petertorelli/marvin3/README.md

# Introduction

## Part 1: Motor Controller

See the readme in [readme in the mc folder](https://github.com/petertorelli/marvin3/blob/main/mc/README.md) the motor controller.
