petertorelli/marvin3/mc/images/voltage-across-bootstrap-diode.png

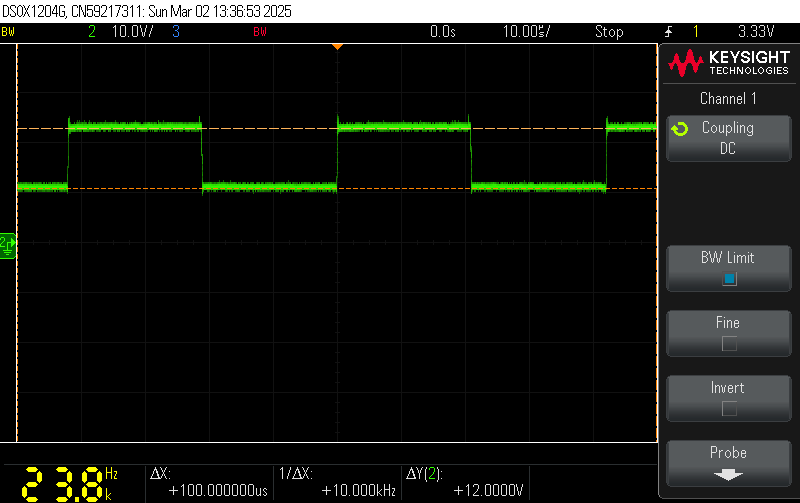
mc/images/voltage-across-bootstrap-diode.png
