petertorelli/marvin3/mc/kicad/ifx-mc-1.0.kicad_pcb

## KiCad design mc/kicad/ifx-mc-1.0.kicad_pcb (2025-03-07)

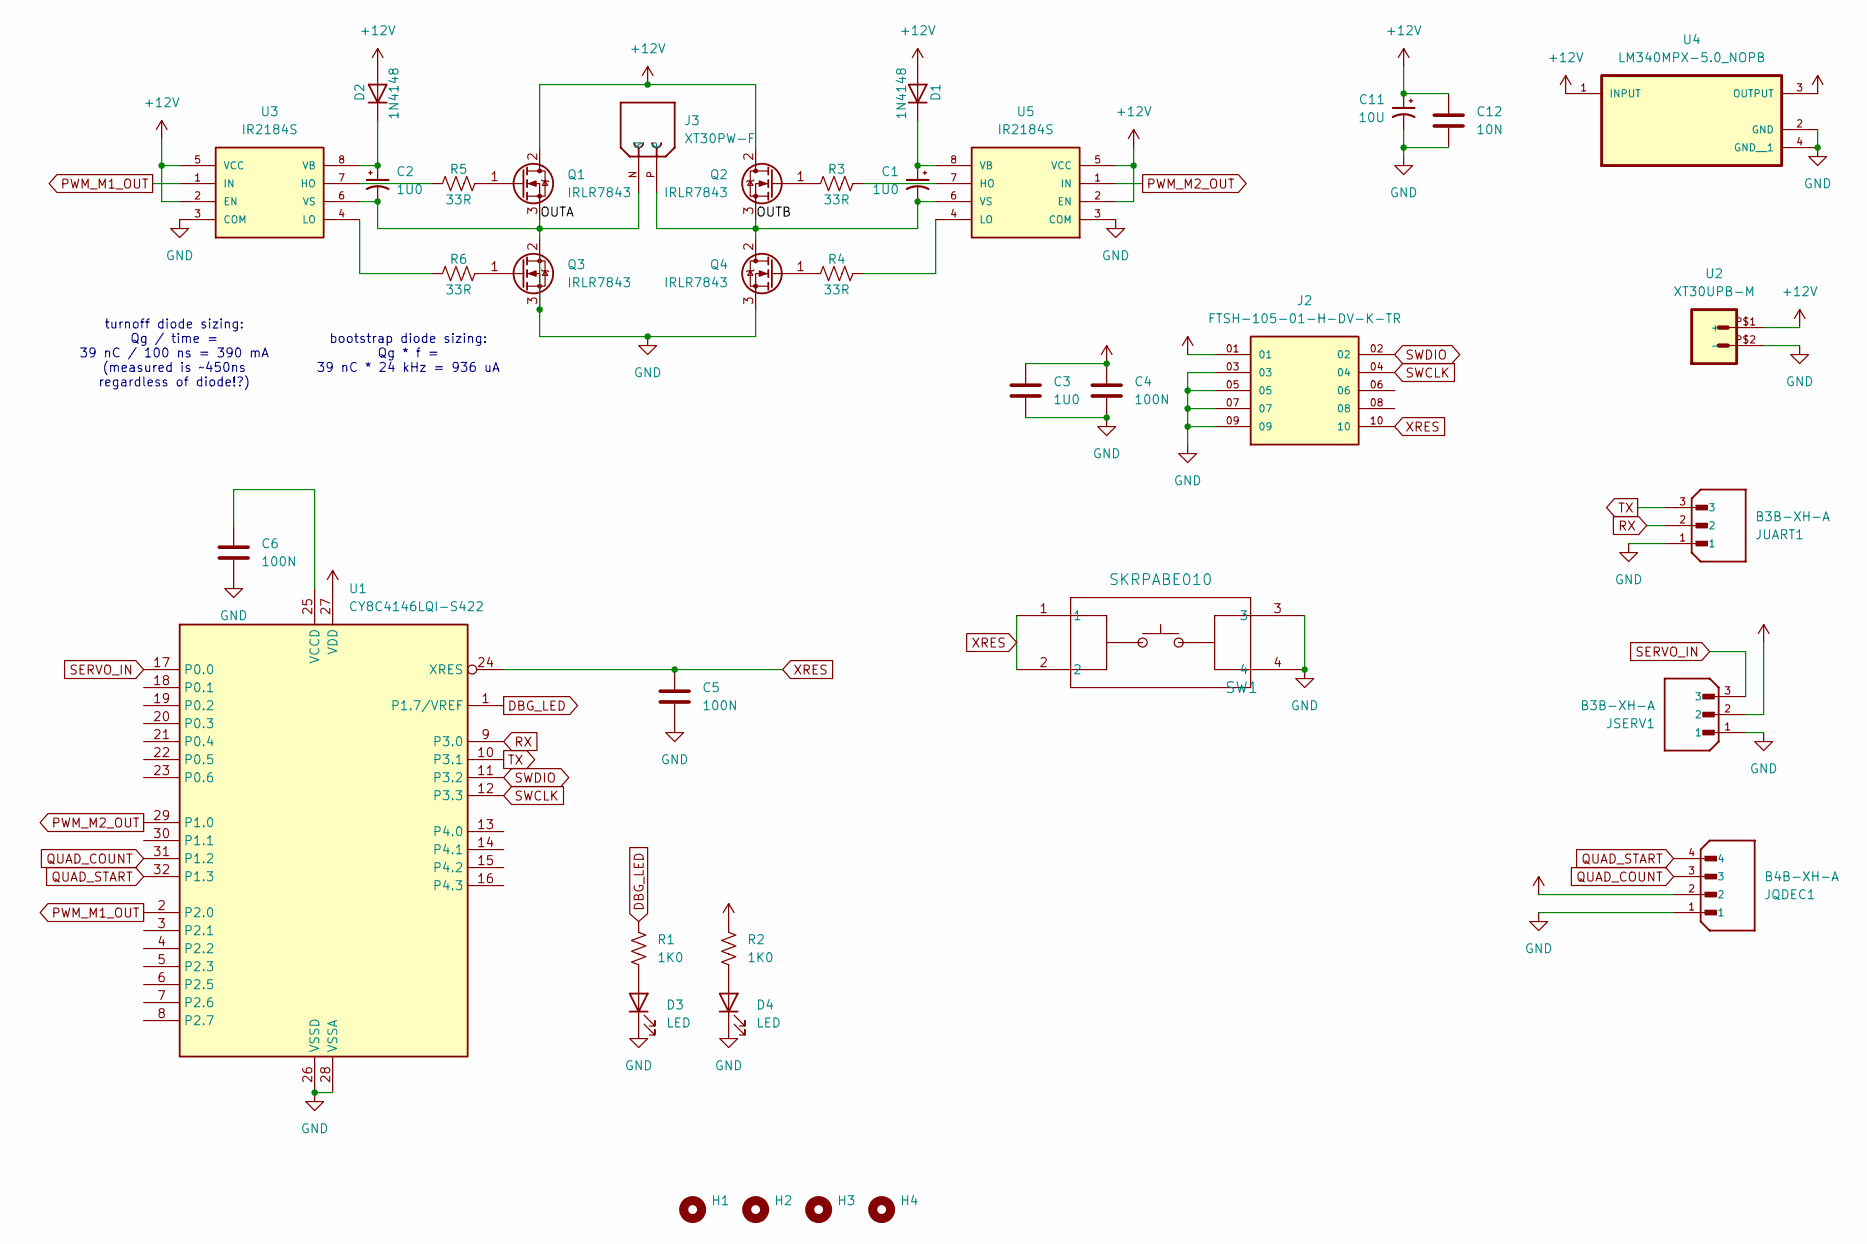
[picture p11: schematic ifx-mc-1.0.kicad_sch]

Parts:
C1, C2: 1U0; C_0603_1608Metric
C3: 1U0; C_0805_2012Metric
C4, C5, C6: 100N; C_0603_1608Metric
C11: 10U; CAP_865230340001
C12: 10N; C_0805_2012Metric
D1, D2: 1N4148; D_0603_1608Metric
D3, D4: LED; LED_0603_1608Metric_Pad1.05x0.95mm_HandSolder
H1, H2, H3, H4: MountingHole; MountingHole_3.2mm_M3_DIN965
J2: FTSH-105-01-H-DV-K-TR; SAMTEC_FTSH-105-01-H-DV-K-TR; PARTREV R
J3: XT30PW-F; AMASS_XT30PW-F; PARTREV 1.2
JQDEC1: B4B-XH-A; JST_B4B-XH-A; PARTREV 7/4/21
JSERV1: B3B-XH-A; JST_B3B-XH-A; PARTREV 7/4/21
JUART1: B3B-XH-A; JST_B3B-XH-A; PARTREV 7/4/21
Q1, Q2, Q3, Q4: IRLR7843; TO-252-2
R1, R2: 1K0; R_0603_1608Metric_Pad0.98x0.95mm_HandSolder
R3, R4, R5, R6: 33R; R_0603_1608Metric
SW1: SKRPABE010; SW4_SKRPABE010_ALPS
U1: CY8C4146LQI-S422; VQFN-32-1EP_5x5mm_P0.5mm_EP3.5x3.5mm
U2: XT30UPB-M
U3, U5: IR2184S; SOIC8_INF; MPN IR2184S
U4: LM340MPX-5.0_NOPB; SOT230P700X180-4N

Connections:
+12V: C11.1, C12.1, D1.2 (A), D2.2 (A), Q1.2 (D), Q2.2 (D), U2.P$1 (+), U3.2 (EN), U3.5 (VCC), U4.1 (INPUT), U5.2 (EN), U5.5 (VCC)
/OUTA: C2.2, J3.N, Q1.3 (S), Q3.2 (D), U3.6 (VS)
/OUTB: C1.2, J3.P, Q2.3 (S), Q4.2 (D), U5.6 (VS)
DBG_LED: R1.1, U1.1 (P1.7/VREF)
GND: C3.2, C4.2, C5.2, C6.2, C11.2, C12.2, D3.1 (K), D4.1 (K), J2.03, J2.05, J2.07, J2.09, JQDEC1.1, JSERV1.1, JUART1.1, Q3.3 (S), Q4.3 (S), SW1.3, SW1.4, U1.26 (VSSD), U1.28 (VSSA), U2.P$2 (-), U3.3 (COM), U4.2 (GND), U4.4 (GND__1), U5.3 (COM)
unnamed: C1.1, D1.1 (K), U5.8 (VB)
unnamed: C2.1, D2.1 (K), U3.8 (VB)
unnamed: D3.2 (A), R1.2
unnamed: D4.2 (A), R2.2
unnamed: Q1.1 (G), R5.1
unnamed: Q2.1 (G), R3.2
unnamed: Q3.1 (G), R6.1
unnamed: Q4.1 (G), R4.2
unnamed: C6.1, U1.25 (VCCD)
unnamed: R5.2, U3.7 (HO)
unnamed: R6.2, U3.4 (LO)
unnamed: R3.1, U5.7 (HO)
unnamed: R4.1, U5.4 (LO)
PWM_M1_OUT: U1.2 (P2.0), U3.1 (IN)
PWM_M2_OUT: U1.29 (P1.0), U5.1 (IN)
QUAD_COUNT: JQDEC1.3, U1.31 (P1.2)
QUAD_START: JQDEC1.4, U1.32 (P1.3)
RX: JUART1.2, U1.9 (P3.0)
SERVO_IN: JSERV1.3, U1.17 (P0.0)
SWCLK: J2.04, U1.12 (P3.3)
SWDIO: J2.02, U1.11 (P3.2)
TX: JUART1.3, U1.10 (P3.1)
VCC: C3.1, C4.1, J2.01, JQDEC1.2, JSERV1.2, R2.1, U1.27 (VDD), U4.3 (OUTPUT)
XRES: C5.1, J2.10, SW1.1, SW1.2, U1.24 (XRES)

Notes on the sheet:
bootstrap diode sizing: Qg * f = 39 nC * 24 kHz = 936 uA
turnoff diode sizing: Qg / time = 39 nC / 100 ns = 390 mA (measured is ~450ns regardless of diode!?)

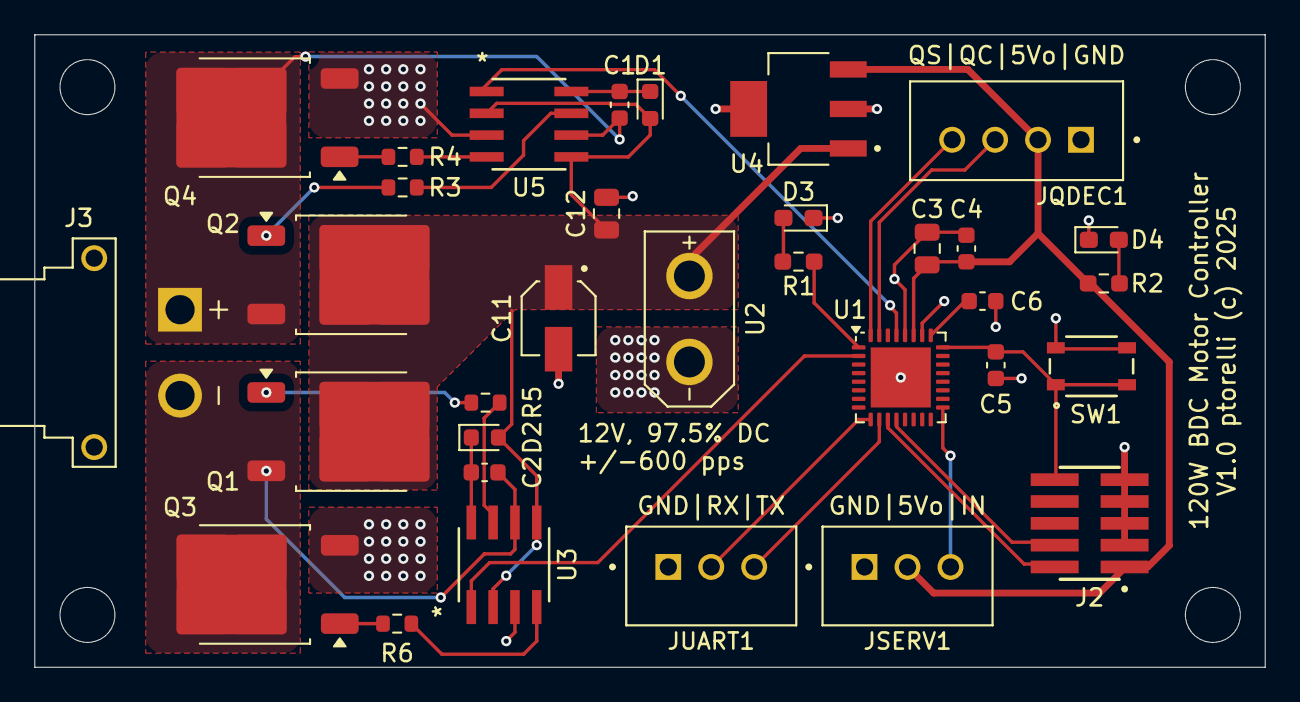
[picture p12: board ifx-mc-1.0.kicad_pcb from above]

Board: 2 copper layers, 71.6 x 36.8 mm, 37 parts (0 on the bottom side), 29 nets.
