petertorelli/marvin3/mc/kicad/ifx-mc-1.0-001.kicad_pcb

## KiCad design mc/kicad/ifx-mc-1.0-001.kicad_pcb (2025-03-07)

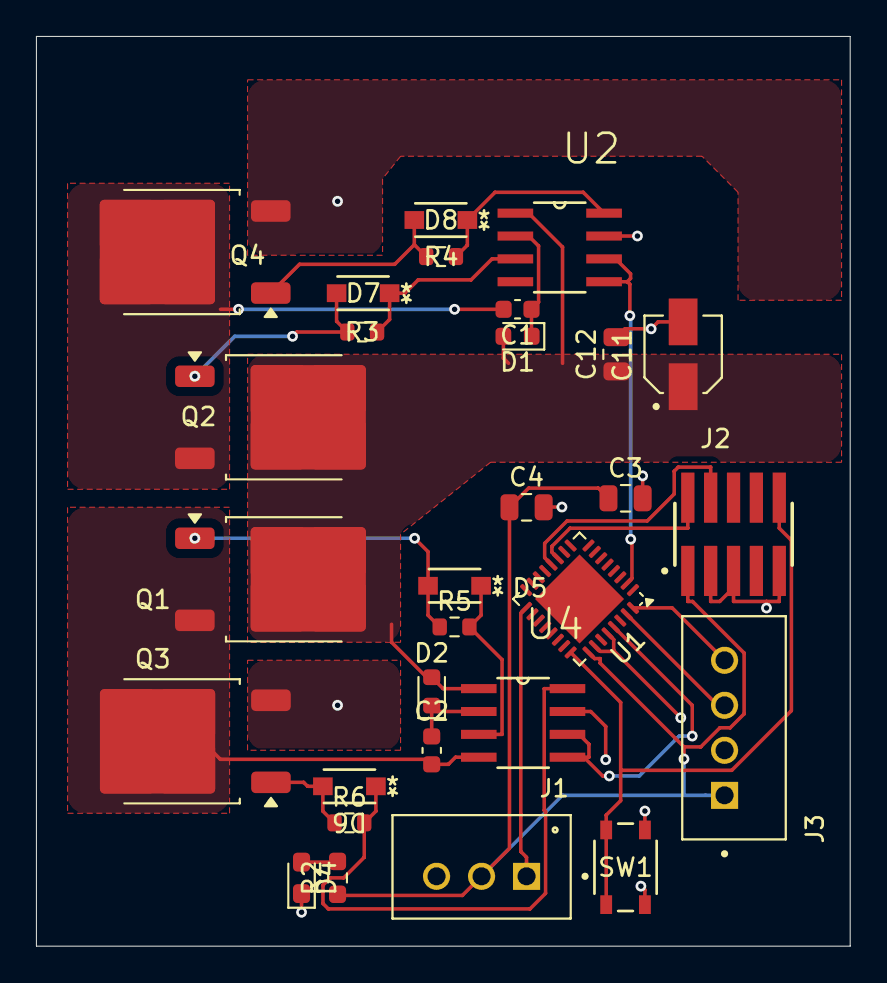
[picture p13: board ifx-mc-1.0-001.kicad_pcb from above]

Board: 2 copper layers, 45.2 x 50.5 mm, 29 parts (0 on the bottom side), 24 nets.

Parts:
C1, C2: 1U0; C_0603_1608Metric
C3, C4: C; C_0805_2012Metric
C11: 10U; CAP_865230340001
C12: 10N; C_0805_2012Metric
D1, D2: 1N4148; D_0603_1608Metric
D4: LED; LED_0603_1608Metric_Pad1.05x0.95mm_HandSolder
D5, D6, D7, D8: RF071MM2S; DIO_RB051MM_ROM
J1: B3B-XH-A; JST_B3B-XH-A
J2: FTSH-105-01-H-DV-K-TR; SAMTEC_FTSH-105-01-H-DV-K-TR
J3: B4B-XH-A; JST_B4B-XH-A
Q1, Q2, Q3, Q4: IRLR7843; TO-252-2
R2: R_US; R_0603_1608Metric_Pad0.98x0.95mm_HandSolder
R3, R4, R5, R6: 33; R_0603_1608Metric
SW1: SKRPABE010; SW4_SKRPABE010_ALPS
U1: CY8C4146LQI-S422; VQFN-32-1EP_5x5mm_P0.5mm_EP3.5x3.5mm
U2, U4: IR2011; SOIC127P600X175-8N

Connections:
+12V: C11.1, C12.1, D1.2 (A), D2.2 (A), Q1.2 (D), Q2.2 (D), U2.1 (VCC), U4.1 (VCC)
/OUTA: C2.2, Q1.3 (S), Q3.2 (D), U4.4 (VS)
/OUTB: C1.2, Q2.3 (S), Q4.2 (D), U2.4 (VS)
GND: C3.2, C4.2, C11.2, C12.2, D4.1 (K), J1.3, J2.03, J2.05, J2.09, J3.2, Q3.3 (S), Q4.3 (S), SW1.3, SW1.4, U1.26 (VSSD), U1.28 (VSSA), U2.7 (COM), U4.7 (COM)
unnamed: C1.1, D1.1 (K), U2.2 (VB)
unnamed: C2.1, D2.1 (K), U4.2 (VB)
unnamed: D4.2 (A), R2.2
unnamed: D5.2 (A), Q1.1 (G), R5.1
unnamed: D5.1 (K), R5.2, U4.3 (HO)
unnamed: D6.2 (A), Q3.1 (G), R6.1
unnamed: D6.1 (K), R6.2, U4.8 (LO)
unnamed: D7.2 (A), Q2.1 (G), R3.2
unnamed: D7.1 (K), R3.1, U2.3 (HO)
unnamed: D8.2 (A), Q4.1 (G), R4.2
unnamed: D8.1 (K), R4.1, U2.8 (LO)
PWM_M1_OUT: U1.29 (P1.0), U4.5 (HIN), U4.6 (LIN)
PWM_M2_OUT: U1.2 (P2.0), U2.5 (HIN), U2.6 (LIN)
QUAD_COUNT: J3.3, U1.31 (P1.2)
QUAD_START: J3.4, U1.32 (P1.3)
SERVO_IN: J1.1, U1.17 (P0.0)
SWCLK: J2.04, U1.12 (P3.3)
SWDIO: J2.02, U1.11 (P3.2)
VCC: C3.1, C4.1, J1.2, J2.01, J3.1, R2.1, U1.25 (VCCD), U1.27 (VDD)
XRES: J2.10, SW1.1, SW1.2, U1.24 (XRES)
