petertorelli/marvin3/(notices)

Notices in the files:
mc/kicad/ifx-mc-1.0.kicad_pcb:
V1.0 ptorelli (c) 2025
